klientlouie123/Hayde-Project-2/REYWIL RAVELO - PROPOSED 2-STOREY DUPLEX HOMESTAY_R1.pdf

# STRUCTURAL ANALYSIS AND DESIGN REPORT

# PROPOSED 2-STOREY DUPLEX HOMESTAY

## Purok 2, Sta. Fe, Gen. Luna, Surigao del Norte

# Owner:

# MR. & MRS REYWIL RAVELO

# Calculations Report by:

# Engr. Hayde A. Abedejos

## Civil Engineer, PRC: 8726512 TIN: 276-202-839 Report date: ____________ Rev: 00

I. Structural Design Criteria

### 1.0 Codes and Standards 3.1 Governing Codes 1.1.1 National Structural Code of the Philippines – NSCP 2015 1.1.2 American Concrete Institute – ACI 318-14 1.1.3 American Institute of Steel Construction – AISC 9th Edition 3.2 Governing Standard

ASTM A36 | Specification for Structural Steel
ASTM A53 | Standard Specification for Pipe, Steel, Black and Hot-dipped,
Zinc-Coated, Welded, and Seamless
ASTM A611 | Specification for Steel, Sheet, Carbon, Cold Rolled, Structural
Quality
ASTM A616 | Specification for Deformed and Plain Billet-steel Bars for
Concrete Reinforcement
PNS 49 | Steel Bars for Concrete Reinforcement Specification
ASTM C33/
PNS 49

Standard Specification for Concrete Aggregates

ASTM C39 | Standard Test Method for Compressive Strength of
Cylindrical Concrete Specimen
ASTM C94/
PNS 46

Standard Specification for Ready-Mix Concrete

ASTM C150/
PNS 07

Specification for Portland Cement

PNS 16 | Philippine National Standard for Concreter Hollow Blocks
SG 671 | Specification for the Design of Cold-formed Steel,
Structural Members by AISC

### 2.0 Material Specifications 2.1 Normal weight concrete 28th day compressive strength

(Unless indicated otherwise on the drawings)
2.1.1 | Suspended slab | 21 MPa (3,000 psi)
2.1.2 | Beams and Girders | 21 MPa (3,000 psi)
2.1.3 | Slab on grade, | 21 MPa (3,000 psi)
2.1.4 | Columns, Stairs, | 21 MPa (3,000 psi)
2.1.3 | Footings | 21 MPa (3,000 psi)

### 2.2 Reinforcing steel yield, fy

2.2.1 | For bars 16 mm diameter and smaller | 276 MPa (40,000 psi)
2.2.2 | For bars 20 mm diameter and larger | 414 MPa (60,000 psi)

### 2.3 Structural steel yield, Fy

2.3.1 | For rolled shapes | 250 MPa (36,000 psi)
2.4 Masonry Concrete Compressive Strength, fm | 7.8 MPa (700 psi)
2.5 Masonry Grout Compressive Strength, fc’ | 13.8 MPa (2,000 psi)
2.6 Lean Concrete 28th day compressive strength, fc’ | 10.4 MPa (1,500 psi)

### 3.0 Loading Criteria 3.1 Dead Load, DL

Concrete | 24.00 kN/m³
Steel | 77.00 kN/m³
SDL (tiles, ceiling) | 1.20 kPa

### 3.2 Live Load, LL

Residential Area | 1.90 kPa
Stairs | 2.40 kPa
Exterior Balconies | 2.40 kPa

### 3.3 Wind Load, WL

qz = 47.3x10⁻⁶KzKztKdV

2
Iw (kPa)
where

[Eq. 207-15]

qz=velocity pressure at mean roof height, h Kzt=topographic factor
Kd=wind directionality factor
V=basic wind speed
Iw=importance factor

### 3.4 Seismic Load, EL

Total design base shear
V = CvIW / RT
The total design base shear need not exceed the following: V = 2.5CaIW / R
V = 0.8ZNvIW / R
The total design base shear shall be less than:
V = 0.11CaIW
where:
V = total design shear at the base of the structure Cv = seismic coefficient as set forth in Table 208-8
I = Importance factor given in Table 208-1
W = Total dead load defined in Section 208.5.1.1
R = ductility coefficient set forth in Table 208-11 or 208-13 T = fundamental period of vibration
Z = seismic zone factor as given in Table 208-3
Nv = near source factor as set forth in Table 208-5 and 208-6

II. Construction Notes

### 1.0 General 1.1 The structural drawings shall be used in conjunction with the specifications, the

architectural, mechanical, electrical and civil drawings.
1.2 The contractor shall verify all dimensions and conditions at the site, which shall include the location and dimensions of openings, grooves, reglets, pipe sleeves, conduits, embedded or attached to concrete, etc.
1.3 All dimensions are in millimeters unless otherwise noted.
1.4 All bar diameters and spacing are in millimeters unless otherwise noted.
1.5 All dimensions are in millimeters unless otherwise noted.
1.6 All bar diameters and spacing are in millimeters unless otherwise noted.

### 2.0 Concrete and Reinforcing Steel 2.1 Minimum cover to all reinforcing bars shall be as follows: 2.1.1 Concrete cast against and permanently

exposed to earth | 75 mm

### 2.1.2 Formed surfaces exposed to earth or weather

Diameter 16 mm bars or smaller | 40 mm
Other bars | 50 mm

### 2.1.3 Formed surfaces not exposed directly to weather or earth

Slabs and walls | 20 mm
Beams | 40 mm
Columns | 50 mm
2.2 Reinforcing bars shall be free of rust, grease of other materials likely to impair bond.

2.3 All reinforcing bars shall be accurately and securely placed before pouring concrete or applying mortar or grout.
2.4 Bar splices shall be securely wired together. Splices in reinforced concrete beams, columns and walls, shall be as shown in the details. For Non-structural walls, masonry walls and slabs, splices shall lap a minimum of 40 bar diameters and shall be staggered whenever possible.
2.5 Splices required in the reinforcement of beams/girders framing into columns shall not be located within the column or within a distance of twice the beam/girder depth from the face of the column.
2.6 Lap splices shall be provided within the center half of column height, and the splice length shall not be less than 1.3 times the required development length.
2.7 Contractor shall not be allowed to start placement/installation of reinforcing bars for footings, beams walls, columns, slabs, and other reinforced-concrete structural elements without submittal and approval of placing drawings. Only the structural engineer on record and/or the owner’s engineer are authorized to approve placing drawings which should be submitted and received by the office of the structural engineer on record at least two (2) days prior to start of structural concrete works. Placing drawings must follow the same drawing standards as used in the working drawings of this project and only certified by the contractor’s registered civil or structural engineer.
2.8 Definition of placing drawings: Placing drawings are working drawings for fabrication and placing of reinforcing steel. These drawing must comprise the following: bar lists, schedules, bending details, placing details, placing plans and elevations, grade, size, spacing, length of each bar, splices and their locations and any necessary additional information that must be supplied by the contractor concerning field conditions, field measurements, construction joints, and sequence of placing concrete.

### 3.0 Structural Steel 3.1 All materials and workmanship shall conform to the ninth edition of the American

Institute of Steel Construction (AISC) Manual unless otherwise shown or noted.
3.2 Contractor shall furnish all plates, clip angles, connectors, etc. required for completion of the structure even if every such item is not shown on the contract drawings.

### 3.3 Welding shall be in accordance with the American Welding Society Code AWS D1.1

unless indicated otherwise. Welding electrodes shall be E70XX.
3.4 All bolts and threaded fasteners shall be ASTM A307 unless indicated otherwise.

### 4.0 Masonry

4.1 All concrete hollow blocks masonry walls shall be laid back in running bond. (interlocking course) with full mortar bedding. Stack bond shall be used only when specified.
4.2 All cells shall be solidly filled with concrete grout.

### 5.0 Foundation

5.1 All foundations are spread footings with tie beams.

### 5.2 Footings for CHB walls and other minor structures shall be embedded at least 600 mm

from the finish grade line unless indicated otherwise.

### 5.3 All foundations should have compacted gravel course 100 mm thick or 50 mm thick lean

concrete unless indicated otherwise.

### 6.0 Load Combinations

### 6.1 Steel (Design)

U = 1.4DL | (DSTL1)
U = 1.2DL + 1.6LL | (DSTL2)
U = 1.2DL + 0.5LL + 1.3WX | (DSTL3)
U = 1.2DL + 0.5LL + 1.3WY | (DSTL5)
U = 0.9DL + 1.3WX | (DSTL7)
U = 0.9DL + 1.3WY | (DSTL9)
U = 1.2DL + 0.5LL + EX | (DSTL11)
U = 1.2DL + 0.5LL + -EX | (DSTL12)
U = 1.2DL + 0.5LL + EY | (DSTL13)
U = 1.2DL + 0.5LL + -EY | (DSTL14)
U = 0.9DL + EX | (DSTL15)
U = 0.9DL + -EX | (DSTL16)
U = 0.9DL + EY | (DSTL17)
U = 0.9DL + -EY | (DSTL18)

### 6.2 Concrete (Design)

U = 1.4DL
U = 1.2DL + 1.6LL
U = 1.2DL + 1.0LL + 1.6WX
U = 1.2DL + 1.0LL + -1.6WX U = 1.2DL + 1.0LL + 1.6WY
U = 1.2DL + 1.0LL+ -1.6WY
U = 1.2DL + 0.8WX
U = 1.2DL + -0.8WX
U = 1.2DL + 0.8WY
U = 1.2DL + -0.8WY
U = 0.9DL + 1.6WX
U = 0.9DL - 1.6WX
U = 0.9DL + 1.6WY
U = 0.9DL - 1.6WY
U = 1.2DL + 1.0LL + 1.0EX
U = 1.2DL + 1.0LL + -1.0EX U = 1.2DL + 1.0LL + 1.0EY
U = 1.2DL + 1.0LL + -1.0EY U = 0.9DL + 1.0EX
U = 0.9DL + -1.0EX
U = 0.9DL + 1.0EY
U = 0.9DL + -1.0EY

### 6.3 Steel (Serviceability)

U = 1.0DL
U = 1.0DL + 1.0LL
U = 1.0DL + 0.6WX
U = 1.0DL + -0.6WX
U = 1.0DL + 0.6WY
U = 1.0DL + -0.6WY
U = 1.0DL + 0.75LL + 0.45WX U = 1.0DL + 0.75LL + -0.45WX U = 1.0DL + 0.75LL + 0.45WY U = 1.0DL + 0.75LL + -0.45WY U = 0.6DL + 0.6WX
U = 0.6DL + -0.6WX
U = 0.6DL + 0.6WY
U = 0.6DL + -0.6WY
U = 1.0DL + 0.75LL + 0.53EX U = 1.0DL + 0.75LL + -0.53EX U = 1.0DL + 0.75LL + 0.53EY U = 1.0DL + 0.75LL + -0.53EY U = 0.6DL + 0.7EX
U = 0.6DL + -0.7EX
U = 0.6DL + 0.7EY
U = 0.6DL + -0.7EY

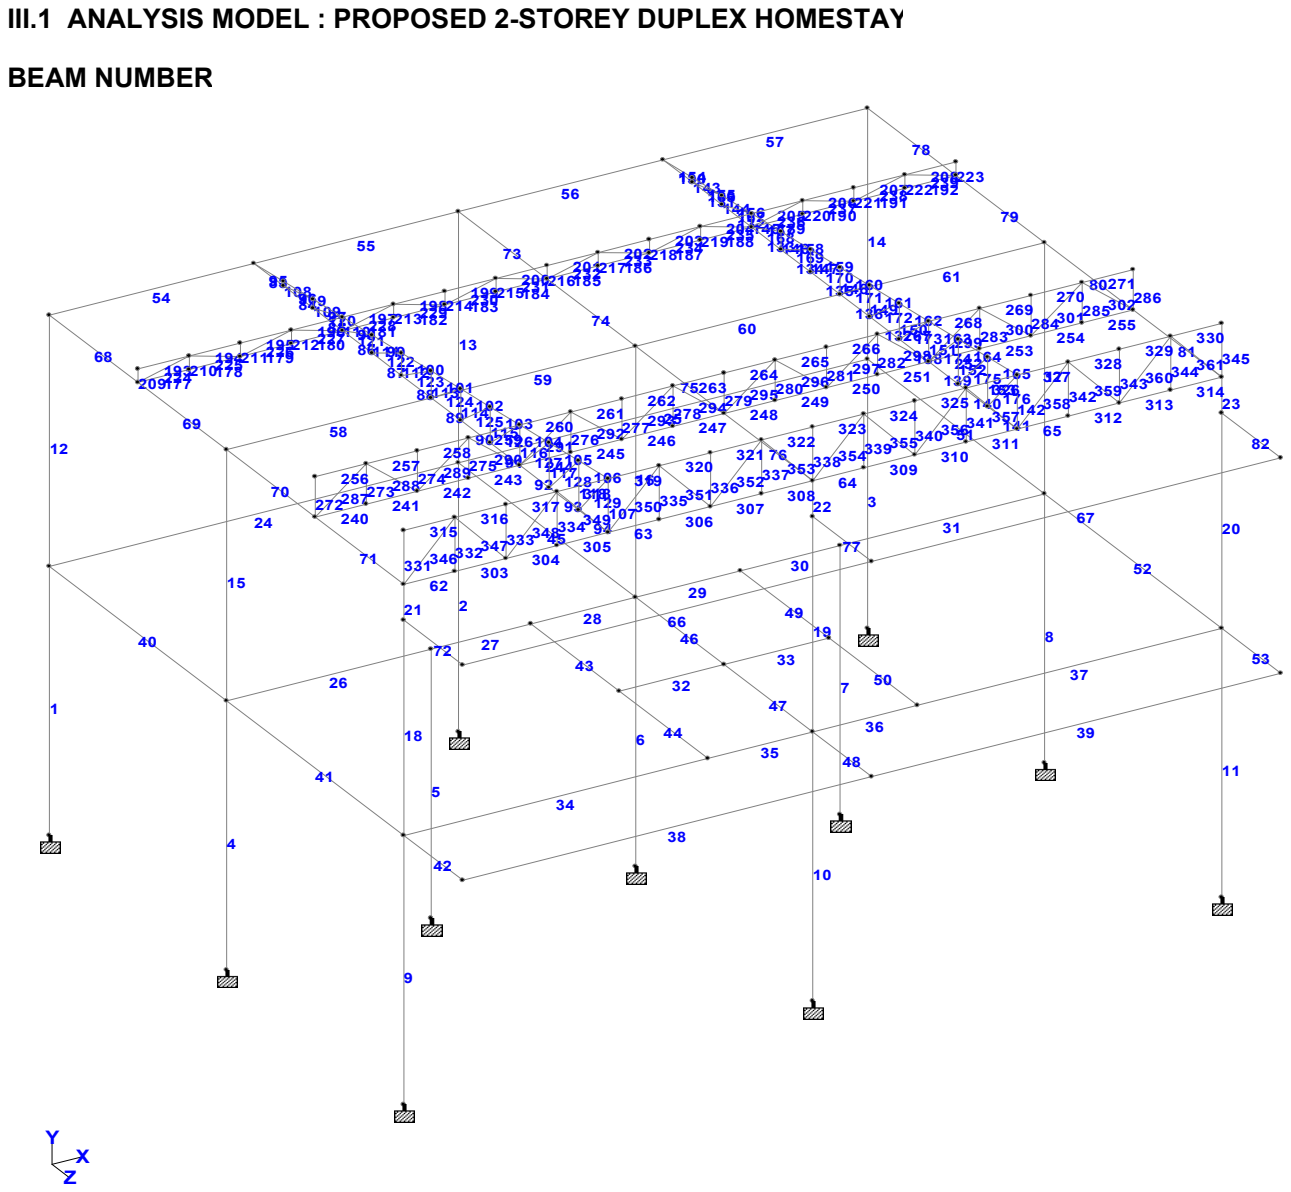
[picture p1: page 7]
BEAM NUMBER

III.1 ANALYSIS MODEL : PROPOSED 2-STOREY DUPLEX HOMESTAY

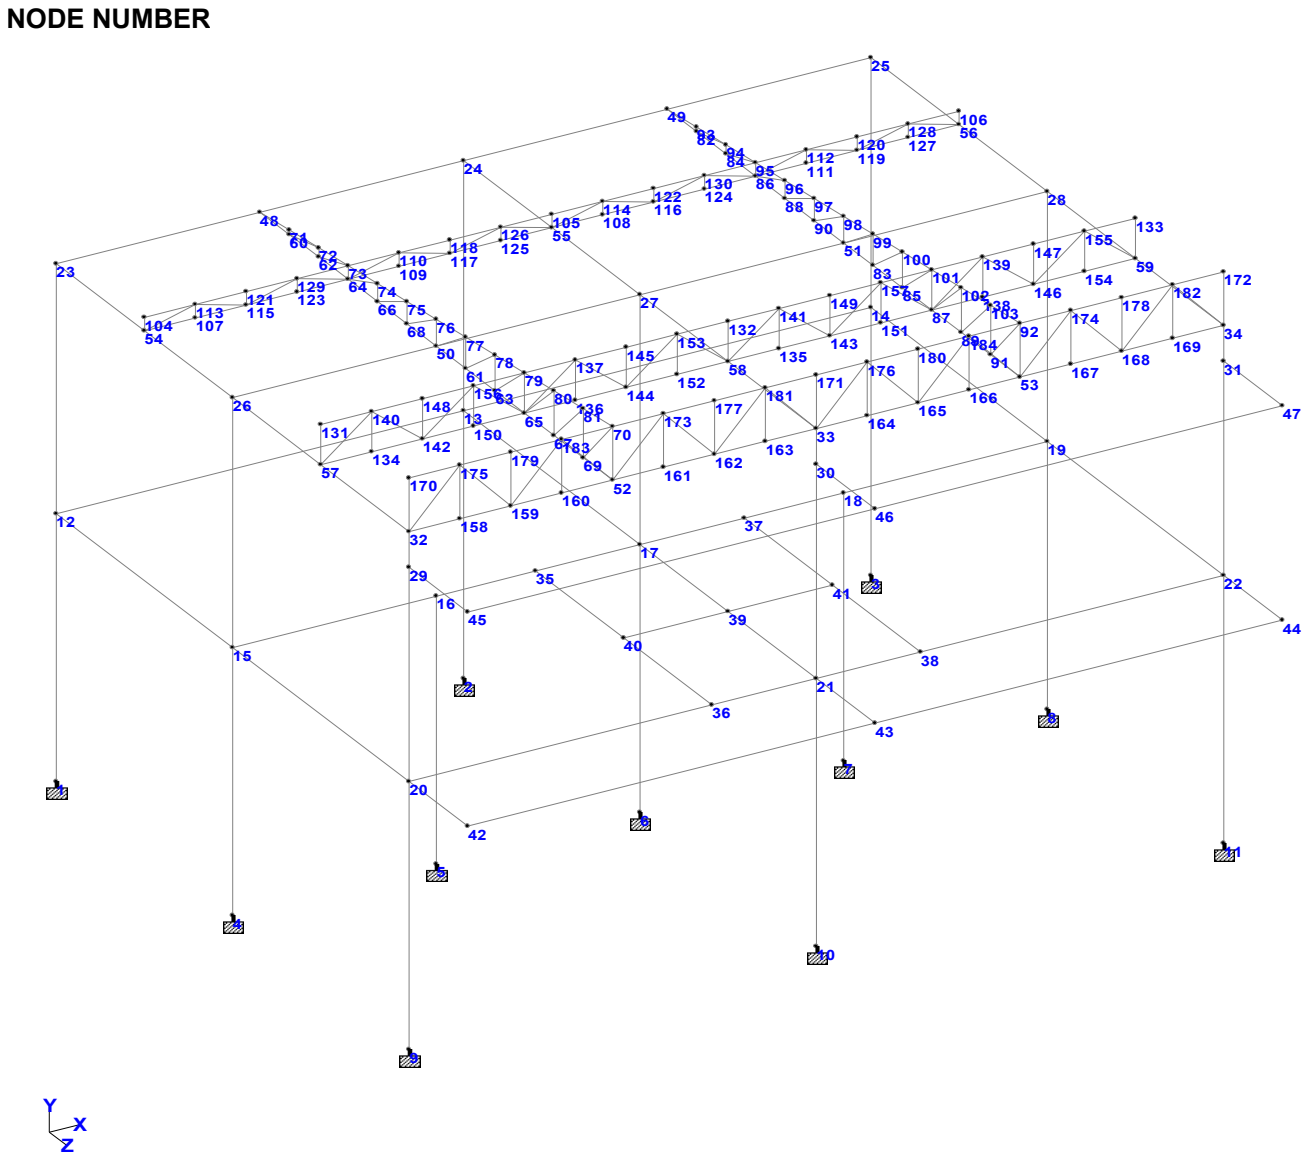
[picture p2: page 8]
NODE NUMBER

III.2 DESIGN OF STEEL MEMBERS: PROPOSED 2-STOREY DUPLEX HOMESTAY

III.2.1 MEMBER STRENGTH CHECK

ALL UNITS ARE - KN | METE (UNLESS OTHERWISE Noted)
MEMBER | TABLE | RESULT/ | CRITICAL COND/ | RATIO/ | LOADING/
| | FX | MY | MZ | LOCATION
=======================================================================
83 LD | L2X2X3/16 | (STANDARD SECTIONS)
| | PASS | Eq. H1-1b | 0.118 | 103
| | 2.21 T | 0.08 | -0.10 | 0.00
84 LD | L2X2X3/16 | (STANDARD SECTIONS)
| | PASS | Eq. H1-1b | 0.104 | 105
| | 2.60 T | 0.03 | 0.07 | 0.00
85 LD | L2X2X3/16 | (STANDARD SECTIONS)
| | PASS | Eq. H1-1b | 0.049 | 101
| | 1.84 T | -0.00 | 0.04 | 0.00
86 LD | L2X2X3/16 | (STANDARD SECTIONS)
| | PASS | Eq. H1-1b | 0.057 | 103
| | 1.98 T | 0.07 | -0.02 | 0.00
87 LD | L2X2X3/16 | (STANDARD SECTIONS)
| | PASS | Eq. H1-1b | 0.052 | 103
| | 1.44 T | -0.05 | 0.02 | 0.50
88 LD | L2X2X3/16 | (STANDARD SECTIONS)
| | PASS | Eq. H2-1 | 0.120 | 105
| | 1.24 C | -0.08 | -0.10 | 0.50
89 LD | L2X2X3/16 | (STANDARD SECTIONS)
| | PASS | Eq. H2-1 | 0.148 | 103
| | 0.67 C | 0.14 | 0.06 | 0.00
90 LD | L2X2X3/16 | (STANDARD SECTIONS)
| | PASS | Eq. H2-1 | 0.063 | 103
| | 2.60 C | 0.06 | -0.01 | 0.00
91 LD | L2X2X3/16 | (STANDARD SECTIONS)
| | PASS | Eq. H2-1 | 0.112 | 103
| | 4.57 C | -0.10 | -0.03 | 0.50
92 LD | L2X2X3/16 | (STANDARD SECTIONS)
| | PASS | Eq. H2-1 | 0.085 | 103
| | 2.30 C | 0.08 | -0.03 | 0.00
93 LD | L2X2X3/16 | (STANDARD SECTIONS)
| | PASS | Eq. H2-1 | 0.063 | 105
| | 1.19 C | -0.04 | 0.03 | 0.50
94 LD | L2X2X3/16 | (STANDARD SECTIONS)
| | PASS | Eq. H2-1 | 0.138 | 105
| | 0.66 C | -0.08 | -0.13 | 0.50
95 LD | L2X2X3/16 | (STANDARD SECTIONS)
| | PASS | Eq. H2-1 | 0.200 | 106
| | 2.45 C | 0.03 | 0.15 | 0.00

96 LD | L2X2X3/16 | (STANDARD SECTIONS)
PASS | Eq. H2-1 | 0.089 | 105
3.59 C | -0.03 | -0.06 | 0.17
97 LD | L2X2X3/16 | (STANDARD SECTIONS)
PASS | Eq. H2-1 | 0.087 | 103
3.16 C | 0.03 | 0.04 | 0.50
98 LD | L2X2X3/16 | (STANDARD SECTIONS)
PASS | Eq. H2-1 | 0.068 | 101
2.21 C | 0.00 | 0.04 | 0.00
99 LD | L2X2X3/16 | (STANDARD SECTIONS)
PASS | Eq. H2-1 | 0.049 | 105
2.45 C | 0.00 | 0.02 | 0.50
100 LD | L2X2X3/16 | (STANDARD SECTIONS)
PASS | Eq. H2-1 | 0.051 | 101
1.45 C | 0.00 | 0.04 | 0.50
101 LD | L2X2X3/16 | (STANDARD SECTIONS)
PASS | Eq. H1-1b | 0.041 | 104
0.53 T | -0.00 | 0.03 | 0.00
102 LD | L2X2X3/16 | (STANDARD SECTIONS)
PASS | Eq. H1-1b | 0.030 | 101
0.48 T | -0.00 | 0.03 | 0.50
103 LD | L2X2X3/16 | (STANDARD SECTIONS)
PASS | Eq. H1-1b | 0.070 | 103
2.56 T | 0.01 | 0.05 | 0.50
104 LD | L2X2X3/16 | (STANDARD SECTIONS)
PASS | Eq. H1-1b | 0.089 | 103
4.44 T | -0.03 | 0.05 | 0.00
105 LD | L2X2X3/16 | (STANDARD SECTIONS)
PASS | Eq. H1-1b | 0.047 | 103
2.23 T | 0.01 | 0.03 | 0.50
106 LD | L2X2X3/16 | (STANDARD SECTIONS)
PASS | Eq. H1-1b | 0.041 | 103
0.74 T | 0.01 | 0.03 | 0.00
107 ST | L2X2X3/16 | (STANDARD SECTIONS)
PASS | Eq. H2-1 | 0.017 | 107
0.34 C | -0.00 | -0.00 | 0.00
108 ST | L2X2X3/16 | (STANDARD SECTIONS)
PASS | Eq. H2-1 | 0.012 | 101
0.26 C | -0.00 | -0.00 | 0.00
109 ST | L2X2X3/16 | (STANDARD SECTIONS)
PASS | Eq. H2-1 | 0.027 | 101
0.57 C | -0.00 | -0.00 | 0.00
110 ST | L2X2X3/16 | (STANDARD SECTIONS)
PASS | Eq. H2-1 | 0.050 | 101
1.05 C | -0.00 | -0.00 | 0.00
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
PASS | DEFLECTION | 0.012 | 2003
0.29
| DEFLECTION CHECK: | (UNIT: CM | ) | | | | |
| Limit Span/Deflection (DFF) : | 300.000 | Limit | : | 0.167 | |
| Span/Deflection | : | 2.58E+04 | Deflection : | 0.002 | |
| L/C | : | 2003 | LOC | : | 0.292 | |
| Ratio | : | 0.012 | (PASS) | | | |

PROJECT | PROPOSED 2-STOREY DUPLEX HOMESTAY
OWNER/CLIENT | MR. & MRS. REYWIL RAVELO
ADDRESS | PUROK 2, STA. FE, GEN. LUNA, SURIGAO DEL NORTE
Slab Designation: | S-1(1)
Occupancy Type | Residential | min t = | 77.778 | mm | OK!
Concrete strength, fc' | 21 | MPa | reqd d = | 100 | mm | OK!
Rebars, fy | 276 | MPa | φVc | 48.690 | kN | OK!
Short span, La | 3 | m | | Mu | reqd s | use s
Long span, Lb | 4 | m | | kNm | mm | mm
Dead load, sdl | 1.2 | kPa | M1, dis = | 5.001 | 213.168 | 200
Live load, sll | 1.9 | kPa | M2, mid = | 3.076 | 350.584 | 300
use slab thickness, t | 100 | mm | M3, cont = | 1.025 | 1064.182 | 300
Main bar diameter, db | 10 | mm | Temp = | 1.579392 | 595.090 | 300
Temp bar diameter, db | 10 | mm | Temp = | 1.666816 | 563.501 | 300
Concrete cover | 20 | mm | Temp = | 0.555605333 | 1704.752 | 300
Slab Designation: | S-1(2)
Occupancy Type | Residential | min t = | 66.389 | mm | OK!
Concrete strength, fc' | 21 | MPa | reqd d = | 100 | mm | OK!
Rebars, fy | 276 | MPa | φVc | 48.690 | kN | OK!
Short span, La | 2.975 | m | | Mu | reqd s | use s
Long span, Lb | k | m | kNm | mm | mm
Dead load, sdl | 1.2 | kPa | M1, dis = | 2.459 | 440.085 | 300
Live load, sll | 1.9 | kPa | M2, mid = | 1.666 | 652.613 | 300
use slab thickness, t | 100 | mm | M3, cont = | 0.555 | 1970.134 | 300
Main bar diameter, db | 10 | mm | Temp = | 3.62408312 | 255.229 | 250
Temp bar diameter, db | 10 | mm | Temp = | 1.546128 | 608.047 | 300
Concrete cover | 20 | mm | Temp = | 0.515376 | 1838.373 | 300
Slab Designation: | S-1(3)
Occupancy Type | Residential | min t = | 23.611 | mm | OK!
Concrete strength, fc' | 21 | MPa | reqd d = | 100 | mm | OK!
Rebars, fy | 276 | MPa | φVc | 48.690 | kN | OK!
Short span, La | 0.825 | m | | Mu | reqd s | use s
Long span, Lb | k | m | kNm | mm | mm
Dead load, sdl | 1.2 | kPa | M1, dis = | 0.423 | 2588.099 | 300
Live load, sll | 1.9 | kPa | M2, mid = | 0.227 | 4833.567 | 300
use slab thickness, t | 100 | mm | M3, cont = | 0.076 | 14512.866 | 300
Main bar diameter, db | 10 | mm | Temp = | 0.02986038 | 31843.823 | 300
Temp bar diameter, db | 10 | mm | Temp = | 0.06484192 | 14660.630 | 300
Concrete cover | 20 | mm | Temp = | 0.021613973 | 43995.911 | 300
Mark | Slab t (mm) | Short direction steel, mm | Long direction steel, mm | Type
| | Main bars | Temp bars
"a" | "b" | "c" | "a" | "b" | "c"
S-1(3) | 100 | 10 mm Ø @ 300 | 10 mm Ø @ 300 | 10 mm Ø @ 300 | 10 mm Ø @ 300 | 10 mm Ø @ 300 | 10 mm Ø @ 300 TWO-WAY
Slab Specification: | Case: | TWO-WAY -

Mark | Slab t (mm) | Short direction steel, mm | Long direction steel, mm | Type
| | Main bars | Temp bars
"a" | "b" | "c" | "a" | "b" | "c"
S-1(2) | 100 | 10 mm Ø @ 300 | 10 mm Ø @ 300 | 10 mm Ø @ 300 | 10 mm Ø @ 250 | 10 mm Ø @ 300 | 10 mm Ø @ 300 TWO-WAY
Material Specification: | | NSCP | 2015
Concrete Strength, fc' = | 21 | MPa | | Steel Reinforcement | db, mm | fy, MPa
Concrete Weight = | Normal | | | Smaller than or equal to | 12 | 276
Unit Weight = | 23.6 | kN/m³ | | Larger than or equal to | 16 414

SLABS

Slab Specification: | TWO-WAY Case:
Mark | Slab t (mm) | Short direction steel, mm | Long direction steel, mm | Type
| | Main bars | Temp bars
"a" | "b" | "c" | "a" | "b" | "c"
S-1(1) | 100 | 10 mm Ø @ 200 | 10 mm Ø @ 300 | 10 mm Ø @ 300 | 10 mm Ø @ 300 | 10 mm Ø @ 300 | 10 mm Ø @ 300 TWO-WAY
Slab Specification: | Case: | TWO-WAY

PROJECT | PROPOSED 2-STOREY DUPLEX HOMESTAY
OWNER/CLIENT | MR. & MRS. REYWIL RAVELO
ADDRESS | PUROK 2, STA. FE, GEN. LUNA, SURIGAO DEL NORTE
Slab Designation: | S-1(4)
Occupancy Type | Residential | min t = | 21.512 | mm | OK!
Concrete strength, fc' | 21 | MPa | reqd d = | 100 | mm | OK!
Rebars, fy | 276 | MPa | φVc | 48.690 | kN | OK!
Short span, La | 0.65 | m | | Mu | reqd s | use s
Long span, Lb | k | m | kNm | mm | mm
Dead load, sdl | 1.2 | kPa | M1, dis = | 1.423 | 765.150 | 300
Live load, sll | 1.9 | kPa | M2, mid = | 0.129 | 8505.972 | 300
use slab thickness, t | 100 | mm | M3, cont = | 0.113 | 9721.979 | 300
Main bar diameter, db | 10 | mm | Temp = | 0 | 392.699 | 300
Temp bar diameter, db | 10 | mm | Temp = | 0 | 392.699 | 300
Concrete cover | 20 | mm | Temp = | 0 | 392.699 | 300
Slab Designation: | S-2
Occupancy Type | Residential | min t = | 21.512 | mm | OK!
Concrete strength, fc' | 21 | MPa | reqd d = | 140 | mm | OK!
Rebars, fy | 276 | MPa | φVc | 74.658 | kN | OK!
Short span, La | 0.65 | m | | Mu | reqd s | use s
Long span, Lb | k | m | kNm | mm | mm
Dead load, sdl | 1.2 | kPa | M1, dis = | 2.813 | 594.267 | 400
Live load, sll | 1.9 | kPa | M2, mid = | 0.255 | 6598.600 | 400
use slab thickness, t | 140 | mm | M3, cont = | 0.223 | 7541.824 | 400
Main bar diameter, db | 10 | mm | Temp = | 0 | 280.499 | 300
Temp bar diameter, db | 10 | mm | Temp = | 0 | 280.499 | 300
Concrete cover | 20 | mm | Temp = | 0 | 280.499 | 300
Concrete, fc' = | 21 | MPa | | Steel fy = | 276 | MPa for 10d and smaller
| | | | Steel fy = | 414 | MPa for 12d and larger
Mark | Slab t (mm) | Short direction steel, mm | Long direction steel, mm | Type
| | Main bars | Temp bars
"a" | "b" | "c" | "a" | "b" | "c"
S-1(1) | 100 | 10 mm Ø @ 200 | 10 mm Ø @ 300 | 10 mm Ø @ 300 | 10 mm Ø @ 300 | 10 mm Ø @ 300 | 10 mm Ø @ 300 TWO-WAY
S-1(2) | 100 | 10 mm Ø @ 300 | 10 mm Ø @ 300 | 10 mm Ø @ 300 | 10 mm Ø @ 250 | 10 mm Ø @ 300 | 10 mm Ø @ 300 TWO-WAY
S-1(3) | 100 | 10 mm Ø @ 300 | 10 mm Ø @ 300 | 10 mm Ø @ 300 | 10 mm Ø @ 300 | 10 mm Ø @ 300 | 10 mm Ø @ 300 TWO-WAY
S-1(4) | 100 | 10 mm Ø @ 300 | 10 mm Ø @ 300 | 10 mm Ø @ 300 | 10 mm Ø @ 300 | 10 mm Ø @ 300 | 10 mm Ø @ 300 ONE-WAY
S-2 | 140 | 10 mm Ø @ 400 | 10 mm Ø @ 400 | 10 mm Ø @ 400 | 10 mm Ø @ 300 | 10 mm Ø @ 300 | 10 mm Ø @ 300 ONE-WAY
Mark | Slab t (mm) | Short direction steel, mm | Long direction steel, mm | Type
| | Main bars | Temp bars
"a" | "b" | "c" | "a" | "b" | "c"
S-1(4) | 100 | 10 mm Ø @ 300 | 10 mm Ø @ 300 | 10 mm Ø @ 300 | 10 mm Ø @ 300 | 10 mm Ø @ 300 | 10 mm Ø @ 300 ONE-WAY
Case: | ONE-WAY One end continuous
Mark | Slab t (mm) | Short direction steel, mm | Long direction steel, mm | Type
| | Main bars | Temp bars
"a" | "b" | "c" | "a" | "b" | "c"
S-2 | 140 | 10 mm Ø @ 400 | 10 mm Ø @ 400 | 10 mm Ø @ 400 | 10 mm Ø @ 300 | 10 mm Ø @ 300 | 10 mm Ø @ 300 ONE-WAY

SLAB SCHEDULE

Slab Specification: | Case: | ONE-WAY One end continuous

Slab Specification:

PROJECT | PROPOSED 2-STOREY DUPLEX HOMESTAY
OWNER/CLIENT | MR. & MRS REYWIL RAVELO
ADDRESS | PUROK 2, STA. FE, GEN. LUNA, SURIGAO DEL NORTE
Material Specification: | NSCP | 2015
Concrete Strength, fc' = | 21 | MPa | Coarse aggregate = | 20 | mm | Steel Reinforcement | db, mm | fy, MPa
Concrete Weight = | Normal | | | | | Smaller than or equal to | 12 | 276
Unit Weight = | 24 | kN/m³ | | | | Larger than or equal to | 16 | 414
Beam Designation: | B-1(1) | Moment | Left | Mid | Right
Concrete, fc' = | 21 | MPa | Slab left, dl = | 3.830 | kN/m | Mu (kNm) | 45.577 | 60.194 | 50.515
fy, main = | 276 | MPa | Slab left, ll = | 3.078 | kN/m | use n top | 4 | 2 | 4
fy, shear = | 276 | MPa | Slab right, dl = | 0.000 | kN/m | use n bot | 2 | 5 | 2
Span, L = | 3.8 | m | Slab right, ll = | 0.000 | kN/m | x (m) | reqd s | adopt s
Width, b = | 225 | mm | Beam ll = | 0 | kPa | 0.292 | 664.771 | 1 @50
Depth, h = | 350 | mm | 0.380 | 764.374 | 4 @125
Concrete cover = | 40 | mm | 0.760 | 2165.346 | 4 @125
Main bar, dbf = | 16 | mm | 1.140 | N/A | 4 @125
Stirrup, dbv = | 10 | mm | 1.520 | N/A | 4 @ 125
Stirrup legs = | 2 | | 1.900 | N/A | Rest @ 125
MARK | SECTION | | LOC | | STIRRUPS MAIN BARS
b (mm) | h (mm) | | LEFT | MID | RIGHT
B-1(1) | 225 | 350 | TOP | 4-16 mm Ø | 2-16 mm Ø | 4-16 mm Ø | 10Ø (2 legs) 1 @50mm, 4 @125mm, 4 @125mm, 4 @125mm,4 @ 125mm O.C to CL
| | | BOTTOM | 2-16 mm Ø | 5-16 mm Ø | 2-16 mm Ø
Beam Designation: | B-1(2) | Moment | Left | Mid | Right
Concrete, fc' = | 21 | MPa | Slab left, dl = | 3.510 | kN/m | Mu (kNm) | 39.874 | 50.875 | 43.994
fy, main = | 276 | MPa | Slab left, ll = | 3.078 | kN/m | use n top | 3 | 2 | 4
fy, shear = | 276 | MPa | Slab right, dl = | 0.000 | kN/m | use n bot | 2 | 4 | 2
Span, L = | 2.7 | m | Slab right, ll = | 0.000 | kN/m | x (m) | reqd s | adopt s
Width, b = | 225 | mm | Beam ll = | 0 | kPa | 0.292 | 1376.940 | 1 @50
Depth, h = | 350 | mm | 0.270 | 1291.385 | 3 @125
Concrete cover = | 40 | mm | 0.540 | 5438.789 | 3 @125
Main bar, dbf = | 16 | mm | 0.810 | N/A | 3 @125
Stirrup, dbv = | 10 | mm | 1.080 | N/A | 3 @ 125
Stirrup legs = | 2 | | 1.350 | N/A | Rest @ 125
MARK | SECTION | | LOC | MAIN BARS | STIRRUPS
b (mm) | h (mm) | | LEFT | MID | RIGHT
B-1(2) | 150 | 300 | TOP | 3-16 mm Ø | 2-16 mm Ø | 4-16 mm Ø | 10Ø (2 legs) 1 @50mm, 4 @100mm, 1 @100mm, 1 @200mm,1 @ 200mm O.C to CL
| | | BOTTOM | 2-16 mm Ø | 4-16 mm Ø | 2-16 mm Ø
Beam Designation: | B-1(3) | Moment | Left | Mid | Right
Concrete, fc' = | 21 | MPa | Slab left, dl = | 3.510 | kN/m | Mu (kNm) | 8.490 | 16.126 | 6.052
fy, main = | 276 | MPa | Slab left, ll = | 2.826 | kN/m | use n top | 2 | 2 | 2
fy, shear = | 276 | MPa | Slab right, dl = | 0.000 | kN/m | use n bot | 2 | 2 | 2
Span, L = | 2.7 | m | Slab right, ll = | 0.000 | kN/m | x (m) | reqd s | adopt s
Width, b = | 225 | mm | Beam ll = | 0 | kPa | 0.292 | N/A | 1 @50
Depth, h = | 350 | mm | 0.270 | N/A | 1 @200
Concrete cover = | 40 | mm | 0.540 | N/A | 1 @200
Main bar, dbf = | 16 | mm | 0.810 | N/A | 1 @200
Stirrup, dbv = | 10 | mm | 1.080 | N/A | 1 @ 200
Stirrup legs = | 2 | | 1.350 | N/A | Rest @ 200
MARK | SECTION | | LOC | MAIN BARS | STIRRUPS
b (mm) | h (mm) | | LEFT | MID | RIGHT
B-1(3) | 225 | 350 | TOP | 2-16 mm Ø | 2-16 mm Ø | 2-16 mm Ø | 10Ø (2 legs) 1 @50mm, 1 @200mm, 1 @200mm, 1 @200mm,1 @ 200mm O.C to CL
| | | BOTTOM | 2-16 mm Ø | 2-16 mm Ø | 2-16 mm Ø
Beam Designation: | B-2(1) | Moment | Left | Mid | Right
Concrete, fc' = | 21 | MPa | Slab left, dl = | 1.535 | kN/m | Mu (kNm) | 13.768 | 19.481 | 13.768
fy, main = | 276 | MPa | Slab left, ll = | 1.235 | kN/m | use n top | 2 | 2 | 2
fy, shear = | 276 | MPa | Slab right, dl = | 0.000 | kN/m | use n bot | 2 | 2 | 2
Span, L = | 0.825 | m | Slab right, ll = | 0.000 | kN/m | x (m) | reqd s | adopt s
Width, b = | 200 | mm | Beam ll = | 0 | kPa | 0.292 | N/A | 1 @50
Depth, h = | 350 | mm | 0.083 | N/A | 1 @200
Concrete cover = | 40 | mm | 0.165 | N/A | 1 @200
Main bar, dbf = | 16 | mm | 0.248 | N/A | 1 @200
Stirrup, dbv = | 10 | mm | 0.330 | N/A | 1 @ 200
Stirrup legs = | 2 | | 0.413 | N/A | Rest @ 200
MARK | SECTION | | LOC | MAIN BARS | STIRRUPS
b (mm) | h (mm) | | LEFT | MID | RIGHT
B-2(1) | 200 | 350 | TOP | 2-16 mm Ø | 2-16 mm Ø | 2-16 mm Ø | 10Ø (2 legs) 1 @50mm, 1 @200mm, 1 @200mm, 1 @200mm,1 @ 200mm O.C to CL
| | | BOTTOM | 2-16 mm Ø | 2-16 mm Ø | 2-16 mm Ø
Beam Specification: | CASE: | SINGLY REINFORCED BEAM Both ends continuous
Beam Specification: | CASE: | SINGLY REINFORCED BEAM Both ends continuous
Beam Specification: | CASE: | SINGLY REINFORCED BEAM

Beam Specification:

BEAMS

CASE: SINGLY REINFORCED BEAM Both ends continuous

Both ends continuous

PROJECT | PROPOSED 2-STOREY DUPLEX HOMESTAY
OWNER/CLIENT | MR. & MRS REYWIL RAVELO
ADDRESS | PUROK 2, STA. FE, GEN. LUNA, SURIGAO DEL NORTE
Beam Designation: | B-2(2) | Moment | Left | Mid | Right
Concrete, fc' = | 21 | MPa | Slab left, dl = | 0.756 | kN/m | Mu (kNm) | 11.069 | 16.099 | 16.099
fy, main = | 276 | MPa | Slab left, ll = | 0.608 | kN/m | use n top | 2 | 2 | 2
fy, shear = | 276 | MPa | Slab right, dl = | 0.000 | kN/m | use n bot | 2 | 2 | 2
Span, L = | 3.8 | m | Slab right, ll = | 0.000 | kN/m | x (m) | reqd s | adopt s
Width, b = | 200 | mm | Beam ll = | 0 | kPa | 0.292 | N/A | 1 @50
Depth, h = | 350 | mm | 0.380 | N/A | 1 @200
Concrete cover = | 40 | mm | 0.760 | N/A | 1 @200
Main bar, dbf = | 16 | mm | 1.140 | N/A | 1 @200
Stirrup, dbv = | 10 | mm | 1.520 | N/A | 1 @ 200
Stirrup legs = | 2 | | 1.900 | N/A | Rest @ 200
MARK | SECTION | | LOC | MAIN BARS | STIRRUPS
b (mm) | h (mm) | | LEFT | MID | RIGHT
B-2(2) | 200 | 350 | TOP | 2-16 mm Ø | 2-16 mm Ø | 2-16 mm Ø | 10Ø (2 legs) 1 @50mm, 1 @200mm, 1 @200mm, 1 @200mm,1 @ 200mm O.C to CL
| | | BOTTOM | 2-16 mm Ø | 2-16 mm Ø | 2-16 mm Ø
Beam Designation: | CB-1 | Moment | Left | Mid | Right
Concrete, fc' = | 21 | MPa | Slab left, dl = | 4.484 | kN/m | Mu (kNm) | 36.024 | 22.449 | 22.449
fy, main = | 276 | MPa | Slab left, ll = | 3.610 | kN/m | use n top | 3 | 2 | 2
fy, shear = | 276 | MPa | Slab right, dl = | 0.000 | kN/m | use n bot | 2 | 2 | 2
Span, L = | 3.8 | m | Slab right, ll = | 0.000 | kN/m | x (m) | reqd s | adopt s
Width, b = | 200 | mm | Beam ll = | 0 | kPa | 0.292 | 5913.895 | 1 @50
Depth, h = | 350 | mm | 0.380 | N/A | 4 @125
Concrete cover = | 40 | mm | 0.760 | N/A | 4 @125
Main bar, dbf = | 16 | mm | 1.140 | N/A | 1 @125
Stirrup, dbv = | 10 | mm | 1.520 | N/A | 1 @ 200
Stirrup legs = | 2 | | 1.900 | N/A | Rest @ 200
MARK | SECTION | | LOC | MAIN BARS | STIRRUPS
b (mm) | h (mm) | | LEFT | MID | RIGHT
CB-1 | 200 | 350 | TOP | 3-16 mm Ø | 2-16 mm Ø | 2-16 mm Ø | 10Ø (2 legs) 1 @50mm, 4 @125mm, 4 @125mm, 1 @125mm,1 @ 200mm O.C to CL
| | | BOTTOM | 2-16 mm Ø | 2-16 mm Ø | 2-16 mm Ø
Beam Designation: | RB-1(1) | Moment | Left | Mid | Right
Concrete, fc' = | 21 | MPa | Slab left, dl = | 2.274 | kN/m | Mu (kNm) | 14.091 | 16.275 | 15.390
fy, main = | 276 | MPa | Slab left, ll = | 0.000 | kN/m | use n top | 3 | 2 | 3
fy, shear = | 276 | MPa | Slab right, dl = | 0.000 | kN/m | use n bot | 2 | 3 | 2
Span, L = | 3.8 | m | Slab right, ll = | 0.000 | kN/m | x (m) | reqd s | adopt s
Width, b = | 200 | mm | Beam ll = | 0 | kPa | 0.244 | N/A | 1 @50
Depth, h = | 300 | mm | 0.380 | N/A | 4 @100
Concrete cover = | 40 | mm | 0.760 | N/A | 4 @100
Main bar, dbf = | 12 | mm | 1.140 | N/A | 1 @100
Stirrup, dbv = | 10 | mm | 1.520 | N/A | 1 @ 200
Stirrup legs = | 2 | | 1.900 | N/A | Rest @ 200
MARK | SECTION | | LOC | MAIN BARS | STIRRUPS
b (mm) | h (mm) | | LEFT | MID | RIGHT
RB-1(1) | 200 | 300 | TOP | 3-12 mm Ø | 2-12 mm Ø | 3-12 mm Ø | 10Ø (2 legs) 1 @50mm, 4 @100mm, 4 @100mm, 1 @100mm,1 @ 200mm O.C to CL
| | | BOTTOM | 2-12 mm Ø | 3-12 mm Ø | 2-12 mm Ø
Beam Designation: | RB-1(2) | Moment | Left | Mid | Right
Concrete, fc' = | 21 | MPa | Slab left, dl = | 2.274 | kN/m | Mu (kNm) | 6.852 | 15.420 | 13.414
fy, main = | 276 | MPa | Slab left, ll = | 0.000 | kN/m | use n top | 2 | 2 | 3
fy, shear = | 276 | MPa | Slab right, dl = | 0.000 | kN/m | use n bot | 2 | 3 | 2
Span, L = | 2.7 | m | Slab right, ll = | 0.000 | kN/m | x (m) | reqd s | adopt s
Width, b = | 200 | mm | Beam ll = | 0 | kPa | 0.244 | N/A | 1 @50
Depth, h = | 300 | mm | 0.270 | N/A | 3 @100
Concrete cover = | 40 | mm | 0.540 | N/A | 1 @100
Main bar, dbf = | 12 | mm | 0.810 | N/A | 1 @200
Stirrup, dbv = | 10 | mm | 1.080 | N/A | 1 @ 200
Stirrup legs = | 2 | | 1.350 | N/A | Rest @ 200
MARK | SECTION | | LOC | MAIN BARS | STIRRUPS
b (mm) | h (mm) | | LEFT | MID | RIGHT
RB-1(2) | 200 | 300 | TOP | 2-12 mm Ø | 2-12 mm Ø | 3-12 mm Ø | 10Ø (2 legs) 1 @50mm, 3 @100mm, 1 @100mm, 1 @200mm,1 @ 200mm O.C to CL
| | | BOTTOM | 2-12 mm Ø | 3-12 mm Ø | 2-12 mm Ø

Both ends continuous

Beam Specification: | CASE: | SINGLY REINFORCED BEAM

SINGLY REINFORCED BEAM
Both ends continuous

Both ends continuous

Beam Specification: | CASE: | SINGLY REINFORCED BEAM
Beam Specification: | CASE: | SINGLY REINFORCED BEAM
Beam Specification: | CASE:

Both ends continuous

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

`

Concrete, fc' = | 21 | MPa | | Steel fy = | 276 | MPa for 12d and smaller
| | | | Steel fy = | 414 | MPa for 16d and larger
MARK | SECTION | | LOC | MAIN BARS | STIRRUPS
b (mm) | h (mm) | | LEFT | MID | RIGHT
B-1(1) | 225 | 350 | TOP | 4-16 mm Ø | 2-16 mm Ø | 4-16 mm Ø | 10Ø (2 legs) 1 @50mm, 4 @125mm, 4 @125mm, 4 @125mm,4 @ 125mm O.C to CL
| | | BOTTOM | 2-16 mm Ø | 5-16 mm Ø | 2-16 mm Ø
B-1(2) | 225 | 350 | TOP | 3-16 mm Ø | 2-16 mm Ø | 4-16 mm Ø | 10Ø (2 legs) 1 @50mm, 3 @125mm, 3 @125mm, 3 @125mm,3 @ 125mm O.C to CL
| | | BOTTOM | 2-16 mm Ø | 4-16 mm Ø | 2-16 mm Ø
B-1(3) | 225 | 350 | TOP | 2-16 mm Ø | 2-16 mm Ø | 2-16 mm Ø | 10Ø (2 legs) 1 @50mm, 1 @200mm, 1 @200mm, 1 @200mm,1 @ 200mm O.C to CL
| | | BOTTOM | 2-16 mm Ø | 2-16 mm Ø | 2-16 mm Ø
B-2(1) | 200 | 350 | TOP | 2-16 mm Ø | 2-16 mm Ø | 2-16 mm Ø | 10Ø (2 legs) 1 @50mm, 1 @200mm, 1 @200mm, 1 @200mm,1 @ 200mm O.C to CL
| | | BOTTOM | 2-16 mm Ø | 2-16 mm Ø | 2-16 mm Ø
B-2(2) | 200 | 350 | TOP | 2-16 mm Ø | 2-16 mm Ø | 2-16 mm Ø | 10Ø (2 legs) 1 @50mm, 1 @200mm, 1 @200mm, 1 @200mm,1 @ 200mm O.C to CL
| | | BOTTOM | 2-16 mm Ø | 2-16 mm Ø | 2-16 mm Ø
CB-1 | 200 | 350 | TOP | 3-16 mm Ø | 2-16 mm Ø | 2-16 mm Ø | 10Ø (2 legs) 1 @50mm, 4 @125mm, 4 @125mm, 1 @125mm,1 @ 200mm O.C to CL
| | | BOTTOM | 2-16 mm Ø | 2-16 mm Ø | 2-16 mm Ø
RB-1(1) | 200 | 300 | TOP | 3-12 mm Ø | 2-12 mm Ø | 3-12 mm Ø | 10Ø (2 legs) 1 @50mm, 4 @100mm, 4 @100mm, 1 @100mm,1 @ 200mm O.C to CL
| | | BOTTOM | 2-12 mm Ø | 3-12 mm Ø | 2-12 mm Ø
RB-1(2) | 200 | 300 | TOP | 2-12 mm Ø | 2-12 mm Ø | 3-12 mm Ø | 10Ø (2 legs) 1 @50mm, 3 @100mm, 1 @100mm, 1 @200mm,1 @ 200mm O.C to CL
| | | BOTTOM | 2-12 mm Ø | 3-12 mm Ø | 2-12 mm Ø

SLAB SCHEDULE

### PROPOSED 2-STOREY DUPLEX HOMESTAY MR. & MRS. REYWIL RAVELO PUROK 2, STA. FE, GEN. LUNA, SURIGAO DEL NORTE

### Member: C1-1

### A. Required Loads

Load Case | Member No. | Axial | Shear | Bending
Pu | Vux | Vuz | Mux | Muz
(kN) | (kN) | (kN) | (kN-m) | (kN-m)
Max Comp. | 21 | 67.795 | 0 | 3.414 | -1.707 | 0
Max Fx | 31 | 23.928 | 13.118 | 1.768 | -6.756 | -6.427
Max Fz | 17 | 47.757 | 0 | 9.067 | 11.642 | 0
Max Mx | 33 | 38.174 | 0 | -2.034 | 14.085 | 0
Max Mz | 22 | 39.573 | 12.72 | 1.77 | -0.842 | 17.196
Max Tens. | - | 0 | 0 | 0 | 0 | 0

### B. Design Parameters Material Properties :

wc

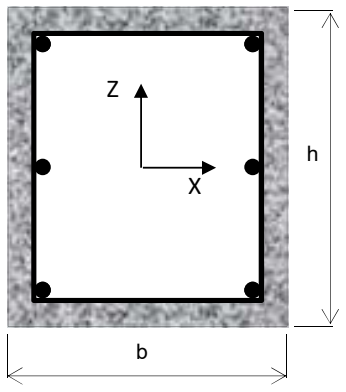
[picture p3: figure]

= | 24.00 | kN/m³ | Design Criteria

f'c

= | 21 | MPa | Design Criteria
fy
= | 276 | MPa | Design Criteria
fyt = | 276 | MPa | Design Criteria

### Column Dimension :

b = | 200 | mm
h = | 300 | mm
L = | 1800 | mm
Cv
= | 50 | mm | Design Criteria
Gross Concrete Area : | A = | 60000 mm
| | 2

### Steel Rebar :

db

= | 16 | mm
tb
= | 10 | mm | Sect. 7.10.5.1

### Bar Arrangement

tpb = | 2 | nos.
btb = | 2 | nos.
lsb = | 3 | nos.
rsb = | 3 | nos.
bn
= | 6 | nos. | Sect. 10.9.2
Ast = | 1206 | mm
| | 2
Scx = | 48 | mm | Sect. 7.6.3
Scz = | 66 | mm | Sect. 7.6.3
ρ = | 2.0% | | Sect. 10.9.1

### C. Check for Slenderness

| Nonsway

### Lux = 3000.0 mm

### Luz = 3000.0 mm

kx = | 1.0
kz = | 1.0

### Address :

### Unsupported length along X :

### Unsupported length along Z : Effective Length Factor X-dir : Effective Length Factor Z-dir :

### Main Steel Bar Strength:

≥ 200 mm

### Sec. Steel Bar Strength:

### Height :

### Bracing Condition :

### Width :

### Concrete Cover :

### Main Vertical Bar Diameter :

### Steel Area :

### Clear Spacing X-direction :

### Clear Spacing Y-direction : Steel Ratio :

### Left Side Bars :

b * h

### DESIGN OF RECTANGULAR CONCRETE COLUMN

### Compressive Strength :

### Concrete Weight :

### Owner/Client :

### Project :

### ≥ Ø12mm

≥ 4 nos.

### ≥ Ø10mm

### Depth :

### Tie Bar Diameter :

### Top Side Bars : Bottom Side Bars :

≥ 200 mm

≥ max(40mm, 1.5db, (4/3)dagg)

### Right Side Bars : No. of Vert. Bars :

≥ max(40mm, 1.5db, (4/3)dagg) 1% ≤ ρ ≤ 8%

# ϕP ϕ 0.85 f′ A

# A f A

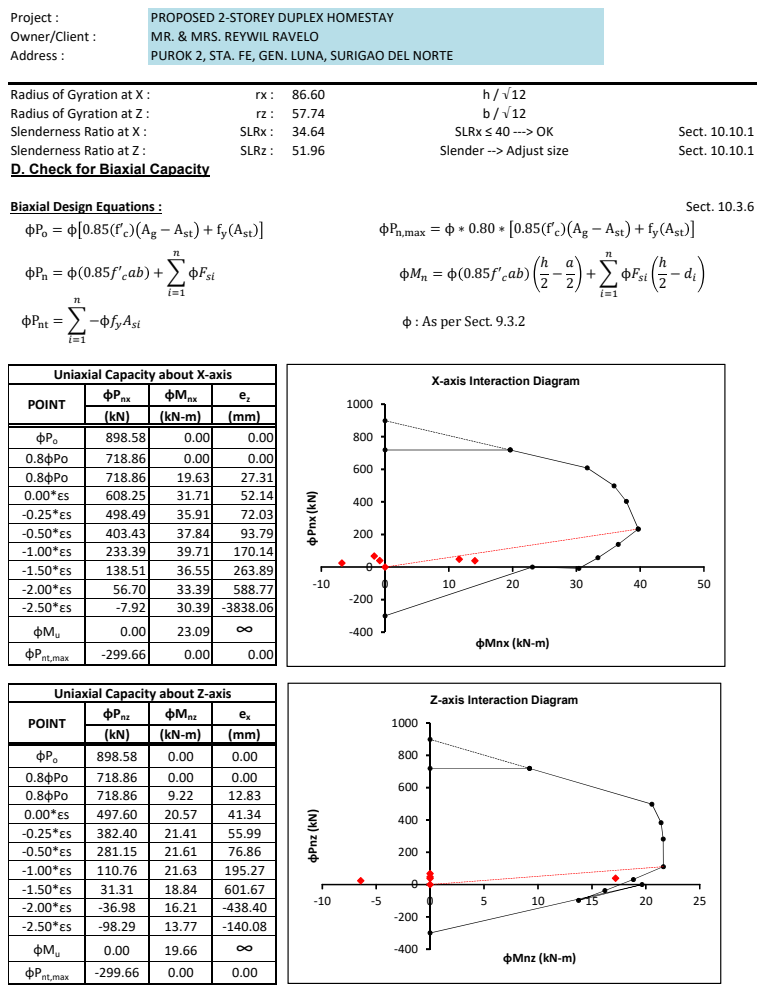
[picture p4: page 58]
Address :; PUROK 2, STA. FE, GEN. LUNA, SURIGAO DEL NORTE; Owner/Client :; Project :; SLRx :; Sect. 10.10.1; SLRz :; Biaxial Design Equations :; Sect. 10.3.6; Slender --> Adjust size; SLRx ≤ 40 ---> OK; 50 φPnx ⁽kN⁾; φMnx (kN-m); 25 φPnz ⁽kN⁾; φMnz (kN-m)

PROPOSED 2-STOREY DUPLEX HOMESTAY
MR. & MRS. REYWIL RAVELO

Radius of Gyration at X :
Radius of Gyration at Z :
Slenderness Ratio at X :
Slenderness Ratio at Z :
D. Check for Biaxial Capacity

φ : As per Sect. 9.3.2

Uniaxial Capacity about X-axis

X-axis Interaction Diagram

POINT | φPnx | φMnx | ez

φPo | 898.58 | 0.00 | 0.00
0.8φPo | 718.86 | 0.00 | 0.00
0.8φPo | 718.86 | 19.63 | 27.31
0.00*εs | 608.25 | 31.71 | 52.14
-0.25*εs | 498.49 | 35.91 | 72.03
-0.50*εs | 403.43 | 37.84 | 93.79
-1.00*εs | 233.39 | 39.71 | 170.14
-1.50*εs | 138.51 | 36.55 | 263.89
-2.00*εs | 56.70 | 33.39 | 588.77
-2.50*εs | -7.92 | 30.39 | -3838.06
φMu | 0.00 | 23.09 | ∞

φPnt,max | -299.66 | 0.00 | 0.00

Uniaxial Capacity about Z-axis

Z-axis Interaction Diagram

POINT | φPnz | φMnz | ex

0.8φPo | 718.86 | 9.22 | 12.83
0.00*εs | 497.60 | 20.57 | 41.34
-0.25*εs | 382.40 | 21.41 | 55.99
-0.50*εs | 281.15 | 21.61 | 76.86
-1.00*εs | 110.76 | 21.63 | 195.27
-1.50*εs | 31.31 | 18.84 | 601.67
-2.00*εs | -36.98 | 16.21 | -438.40
-2.50*εs | -98.29 | 13.77 | -140.08
φMu | 0.00 | 19.66 | ∞

### PROPOSED 2-STOREY DUPLEX HOMESTAY MR. & MRS. REYWIL RAVELO

Address : | PUROK 2, STA. FE, GEN. LUNA, SURIGAO DEL NORTE

### Owner/Client :

### Project :

Load Case | euz (mm) | φPnx (kN) | eux (mm) | φPnz (kN) | φPo (kN) | Pu (kN) | Pu ≥ 0.1*Po | φPn (kN) | Ratio (Pu/φPn ) | Remarks
Max Axial | -25.18 | 0.00 | 0.00 | 718.86 | 898.58 | 70.39 | N/A | N/A | N/A | N/A
Max Mx | 368.97 | 0.00 | 0.00 | 718.86 | 898.58 | 40.77 | N/A | N/A | N/A | N/A
Max Mz | -21.28 | 0.00 | 434.54 | -11.39 | 898.58 | 42.17 | N/A | N/A | N/A | N/A
Load Case | euz (mm) | φMnx (kN) | eux (mm) | φMnz (kN) | Mux (kN-m) | Muz (kN-m) | (Mux/φMnx) + (Muz/φMnz) ≤ 1 | Remarks
Max Axial | -25.18 | 33.81 | 0.00 | 20.12 | -1.71 | 0.00 | -0.05 | Pass
Max Mx | 368.97 | 32.53 | 0.00 | 19.08 | 14.09 | 0.00 | 0.43 | Pass
Max Mz | -21.28 | 32.59 | 434.54 | 19.13 | -0.84 | 17.20 | 0.87 | Pass

### Equations:

Po

= (0.85f'c

)(Ag

### -Ast)+fy

### (Ast)

### 1/φPn = 1/φPnx + 1/φPnz - 1/φPo

### E. Check for Shear

Load Case | Nu (kN) | Vux (kN) | Vuz (kN) | Vu (kN)
Max Comp. | 67.80 | 0.00 | 3.41 | 3.41
Max Mz | 38.17 | 0.00 | -2.03 | 2.03
Max My | 39.57 | 12.72 | 1.77 | 12.84
Max Tens. | 0.00 | 0.00 | 0.00 | 0.00
φ = | 0.75 | Sect. 9.3.2
Modificaction Factor : | λ = | 1.0 | Sect. 8.6.1
Nu
= | 39.57 | kN
Vu
= | 12.84 | kN

### φVc

= | 28.39 | kN | Sect. 11.2.1.2
Av,prov = | 157 | mm

2

sreq'd = | N/A | mm

2

### Sect. 11.4.6.1

smin = | 37 | mm
smax = | 200 | mm | Sect. 7.10.5.2
Use s = | 150 | mm

### F. Check for Axial Tension Capacity

φ = 0.9

### φPnt = -299.66 kN

Put = | 0.00 | kN

### Strength Reduction Factor :

### Ø10mm 2-leg ties

### If Pu

≤ 0.1*Po

### Minimum Shear Reinf. :

### Provided Shear Reinf. :

### Required Shear Force :

### Concrete Shear Force :

### Axial Force :

### If Pu

≥ 0.1*Po

### Biaxial Capacity at Design Eccentricty

Required Axial Tension : | φPnt ≥ Pu ----> OK

### Strength Reduction Factor : Pure Axial Tension Capacity :

### Normal weight concrete

φ0.17(1+Nu

/14Ag

)λ√f'cbwd

### -φ*fy * Ast

Minimum Tie Spacing : | (4/3)dagg Vu < 0.5φVc
Maximum Tie Spacing : | min(16db, 48tb, min(b,h)) smin ≤ s ≤ smax ---> OK

56 567

8 569

8

### PROPOSED 2-STOREY DUPLEX HOMESTAY MR. & MRS. REYWIL RAVELO PUROK 2, STA. FE, GEN. LUNA, SURIGAO DEL NORTE

### Member: C1-2

### A. Required Loads

Load Case | Member No. | Axial | Shear | Bending
Pu | Vux | Vuz | Mux | Muz
(kN) | (kN) | (kN) | (kN-m) | (kN-m)
Max Comp. | 10 | 263.082 | 0 | -12.985 | 22.227 | 0
Max Fx | 11 | 135.195 | 12.498 | 1.054 | -1.322 | 18.766
Max Fz | 7 | 43.809 | 0.788 | 19.919 | 30.788 | 1.006
Max Mx | 5 | 80.859 | -0.344 | -19.855 | 30.801 | -1.166
Max Mz | 11 | 135.195 | 12.498 | 1.054 | -1.322 | 18.766
Max Tens. | - | 0 | 0 | 0 | 0 | 0

### B. Design Parameters Material Properties :

wc

= | 24.00 | kN/m³ | Design Criteria

f'c

= | 21 | MPa | Design Criteria
fy
= | 276 | MPa | Design Criteria
fyt = | 276 | MPa | Design Criteria

### Column Dimension :

b = | 200 | mm
h = | 300 | mm
L = | 1800 | mm
Cv
= | 50 | mm | Design Criteria
Gross Concrete Area : | A = | 60000 mm
| | 2

### Steel Rebar :

db

= | 16 | mm
tb
= | 10 | mm | Sect. 7.10.5.1

### Bar Arrangement

tpb = | 2 | nos.
btb = | 2 | nos.
lsb = | 3 | nos.
rsb = | 3 | nos.
bn
= | 6 | nos. | Sect. 10.9.2
Ast = | 1206 | mm
| | 2
Scx = | 48 | mm | Sect. 7.6.3
Scz = | 66 | mm | Sect. 7.6.3
ρ = | 2.0% | | Sect. 10.9.1

### C. Check for Slenderness

| Nonsway

### Lux = 3000.0 mm

### Luz = 3000.0 mm

kx = | 1.0
kz = | 1.0

### Unsupported length along X :

### Unsupported length along Z : Effective Length Factor X-dir : Effective Length Factor Z-dir :

Steel Ratio : | 1% ≤ ρ ≤ 8%

### Bracing Condition :

### Steel Area :

Clear Spacing X-direction : | ≥ max(40mm, 1.5db, (4/3)dagg)
Clear Spacing Y-direction : | ≥ max(40mm, 1.5db, (4/3)dagg)

### Bottom Side Bars : Left Side Bars : Right Side Bars :

No. of Vert. Bars : | ≥ 4 nos.
Tie Bar Diameter : | ≥ Ø10mm
Top Side Bars : | b * h
Main Vertical Bar Diameter : | ≥ Ø12mm

### Height : Concrete Cover :

### Sec. Steel Bar Strength:

Width : | ≥ 200 mm
Depth : | ≥ 200 mm

### Concrete Weight :

### Compressive Strength :

### Main Steel Bar Strength:

### DESIGN OF RECTANGULAR CONCRETE COLUMN

### Project : Owner/Client : Address :

# ϕP ϕ 0.85 f′ A

# A f A

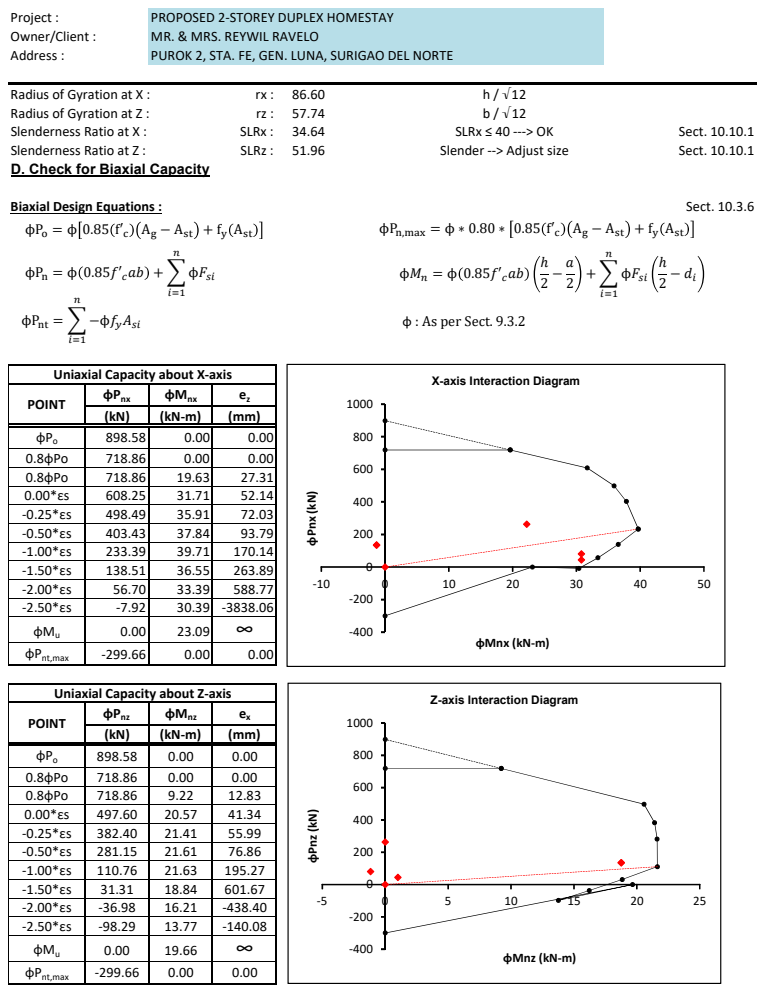
[picture p5: page 61]
Project : Owner/Client : Address :; SLRx :; Sect. 10.10.1; SLRz :; Biaxial Design Equations :; Sect. 10.3.6; Radius of Gyration at Z :; Slenderness Ratio at X :; SLRx ≤ 40 ---> OK; Slenderness Ratio at Z :; Slender --> Adjust size; Radius of Gyration at X :; 50 φPnx ⁽kN⁾; φMnx (kN-m); 25 φPnz ⁽kN⁾; φMnz (kN-m)

PROPOSED 2-STOREY DUPLEX HOMESTAY
MR. & MRS. REYWIL RAVELO
PUROK 2, STA. FE, GEN. LUNA, SURIGAO DEL NORTE

D. Check for Biaxial Capacity

φ : As per Sect. 9.3.2

Uniaxial Capacity about X-axis

X-axis Interaction Diagram

POINT | φPnx | φMnx | ez

φPo | 898.58 | 0.00 | 0.00
0.8φPo | 718.86 | 0.00 | 0.00
0.8φPo | 718.86 | 19.63 | 27.31
0.00*εs | 608.25 | 31.71 | 52.14
-0.25*εs | 498.49 | 35.91 | 72.03
-0.50*εs | 403.43 | 37.84 | 93.79
-1.00*εs | 233.39 | 39.71 | 170.14
-1.50*εs | 138.51 | 36.55 | 263.89
-2.00*εs | 56.70 | 33.39 | 588.77
-2.50*εs | -7.92 | 30.39 | -3838.06
φMu | 0.00 | 23.09 | ∞

φPnt,max | -299.66 | 0.00 | 0.00

Uniaxial Capacity about Z-axis

Z-axis Interaction Diagram

POINT | φPnz | φMnz | ex

0.8φPo | 718.86 | 9.22 | 12.83
0.00*εs | 497.60 | 20.57 | 41.34
-0.25*εs | 382.40 | 21.41 | 55.99
-0.50*εs | 281.15 | 21.61 | 76.86
-1.00*εs | 110.76 | 21.63 | 195.27
-1.50*εs | 31.31 | 18.84 | 601.67
-2.00*εs | -36.98 | 16.21 | -438.40
-2.50*εs | -98.29 | 13.77 | -140.08
φMu | 0.00 | 19.66 | ∞

### PROPOSED 2-STOREY DUPLEX HOMESTAY MR. & MRS. REYWIL RAVELO PUROK 2, STA. FE, GEN. LUNA, SURIGAO DEL NORTE

### Project : Owner/Client : Address :

Load Case | euz (mm) | φPnx (kN) | eux (mm) | φPnz (kN) | φPo (kN) | Pu (kN) | Pu ≥ 0.1*Po | φPn (kN) | Ratio (Pu/φPn ) | Remarks
Max Axial | 84.49 | 695.09 | 0.00 | 718.86 | 898.58 | 265.67 | OK | 582.45 | 0.46 | Pass
Max Mx | 380.92 | 0.87 | -14.42 | 0.00 | 898.58 | 83.45 | N/A | N/A | N/A | N/A
Max Mz | -9.78 | 0.00 | 138.81 | 532.77 | 898.58 | 137.79 | OK | 1308.74 | 0.11 | Pass
Load Case | euz (mm) | φMnx (kN) | eux (mm) | φMnz (kN) | Mux (kN-m) | Muz (kN-m) | (Mux/φMnx) + (Muz/φMnz) ≤ 1 | Remarks
Max Axial | N/A | 0.00 | N/A | 0.00 | N/A | N/A | N/A | N/A
Max Mx | 380.92 | 34.32 | -14.42 | 20.58 | 30.80 | -1.17 | 0.84 | Pass
Max Mz | N/A | 36.42 | N/A | 0.00 | N/A | N/A | N/A | N/A

### Equations:

Po

= (0.85f'c

)(Ag

### -Ast)+fy

### (Ast)

### 1/φPn = 1/φPnx + 1/φPnz - 1/φPo

### E. Check for Shear

Load Case | Nu (kN) | Vux (kN) | Vuz (kN) | Vu (kN)
Max Comp. | 263.08 | 0.00 | -12.99 | 12.99
Max Mz | 80.86 | -0.34 | -19.86 | 19.86
Max My | 135.20 | 12.50 | 1.05 | 12.54
Max Tens. | 0.00 | 0.00 | 0.00 | 0.00
φ = | 0.75 | Sect. 9.3.2
Modificaction Factor : | λ = | 1.0 | Sect. 8.6.1
Nu
= | 80.86 | kN
Vu
= | 19.86 | kN

### φVc

= | 29.72 | kN | Sect. 11.2.1.2
Av,prov = | 157 | mm

2

sreq'd = | 619 | mm

2

### Sect. 11.4.6.1

smin = | 37 | mm
smax = | 200 | mm | Sect. 7.10.5.2
Use s = | 150 | mm

### F. Check for Axial Tension Capacity

φ = 0.9

### φPnt = -299.66 kN

Put = | 0.00 | kN

### smin ≤ s ≤ smax ---> OK

### Strength Reduction Factor :

Pure Axial Tension Capacity : | -φ*fy * Ast
Required Axial Tension : | φPnt ≥ Pu ----> OK
Minimum Shear Reinf. : | Vu > 0.5φVc
Minimum Tie Spacing : | (4/3)dagg
Maximum Tie Spacing : | min(16db, 48tb, min(b,h))

### Normal weight concrete Axial Force :

### Required Shear Force :

Concrete Shear Force : | φ0.17(1+Nu /14Ag )λ√f'cbwd
Provided Shear Reinf. : | Ø10mm 2-leg ties

### If Pu

≤ 0.1*Po

### Strength Reduction Factor :

### Biaxial Capacity at Design Eccentricty If Pu

≥ 0.1*Po

56 567

8 569

8

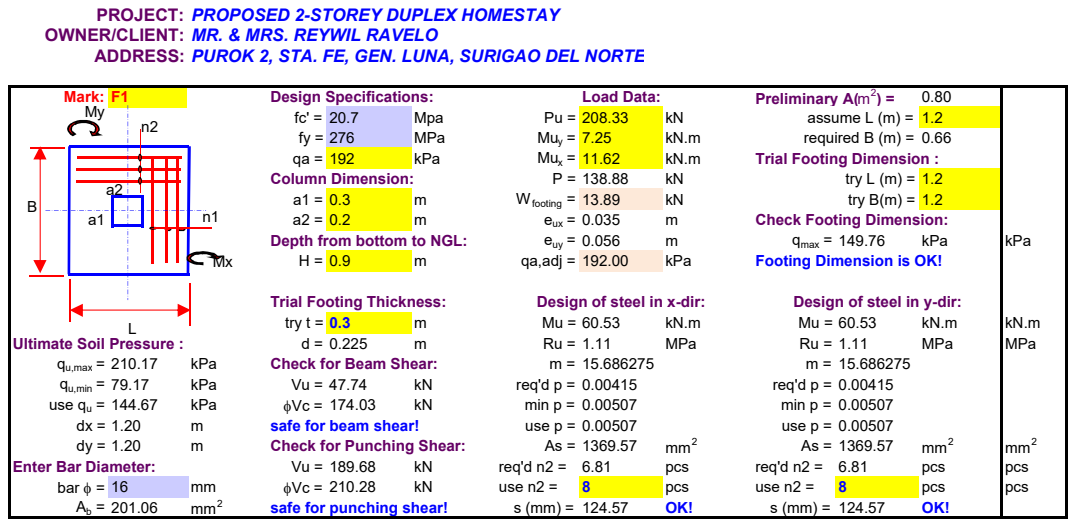
[picture p6: page 63]
Mark: F1; Design Specifications:; Load Data:; Preliminary A(m; Mpa; assume L (m) = 1.2; MPa; Muy; required B (m) = 0.66; kPa; Mux; Trial Footing Dimension :; Column Dimension:; try L (m) = 1.2; Wfooting = 13.89; try B(m) = 1.2; eux = 0.035; Check Footing Dimension:; Depth from bottom to NGL:; euy = 0.056; qmax = 149.76; qa,adj = 192.00; Footing Dimension is OK!; Trial Footing Thickness:; Design of steel in x-dir:; Design of steel in y-dir:; try t = 0.3; Ultimate Soil Pressure :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

PROJECT: PROPOSED 2-STOREY DUPLEX HOMESTAY

OWNER/CLIENT: MR. & MRS. REYWIL RAVELO

ADDRESS: PUROK 2, STA. FE, GEN. LUNA, SURIGAO DEL NORTE
