klientlouie123/Hayde-Project-2/(list of files, cad)

Other CAD files:
Reywil Ravelo Homestay-April 21 2025.dwg
